xouillet/TypeWriter/(threads)

Thread 1 (2022-01-20):

"key" declared void while trying to compile

kog001, 2022-01-20:
First I have to mention that I am a complete noob at progamming so this might be my fault.

I get the following error while trying to compile the code for uploading to a board:

_**sketch_jan20a:240:10: error: variable or field 'key' declared void
 void key(Combi combi)
          ^~~~~
sketch_jan20a:240:10: error: 'Combi' was not declared in this scope
exit status 1
variable or field 'key' declared void**_

The error refers to line 240: void key(Combi combi)

Am I doing something wrong? The only thing that I have modified are the key codes so I can use a different printer. I tested the original code and the error is the same.

Thank you.

xouillet, 2022-01-20:
Hi,

How are you trying to compile the source ?
I just tried to `git clone` and then `make` on the master branch and I have no issue on my side.

xouillet, 2022-01-20:
Ok, looks more like a bug in the arduino IDE than anything because it does not seems to find the struct that is defined earlier.

Anyway, I've separated the struct and the code with a Typewriter.h file and all should be ok now.

kog001, 2022-01-21:
Hello!
It is compiling correctly now. Thank you.

One last question. Is there any chance to run the python file under windows? Or do I need a linux VM?

xouillet, 2022-01-21:
I've never tested it under Windows but it should work, using windows serial port name as `--port` argument (for example `--port COM0`)
