xouillet/TypeWriter/(commit log)

2020-04-04 Enums, modifier handling. Just missing the hard part :)
    [TypeWriter.ino]
2020-04-05 It works !!! Missing modifier handling and some characters
    [TypeWriter.ino]
2020-04-05 Added print.py. Missing flow control, spefic chars and formatting
    [TypeWriter.ino, print.py]
2020-04-05 Added accent, but it doesn't work
    [TypeWriter.ino, print.py]
2020-04-06 print.py: Full write, with typewriter function, wraps.. Arduino now handle circumflex
2020-04-11 Better pin management
2020-04-17 print.py: Wait for serial link to be ready
2022-01-20 Fixes compilation in arduino IDE
    [TypeWriter.h, TypeWriter.ino]
